ChenYehuiCN/vfd-test/(list of files, cad)

Other CAD files:
vfd-test-firmware/Objects/main.obj
vfd-test-firmware/Objects/STARTUP.obj
