ChenYehuiCN/vfd-test/vfd-test-pcb/SCH_vfd-test-pcb_Schematic1_2026-09-13.pdf

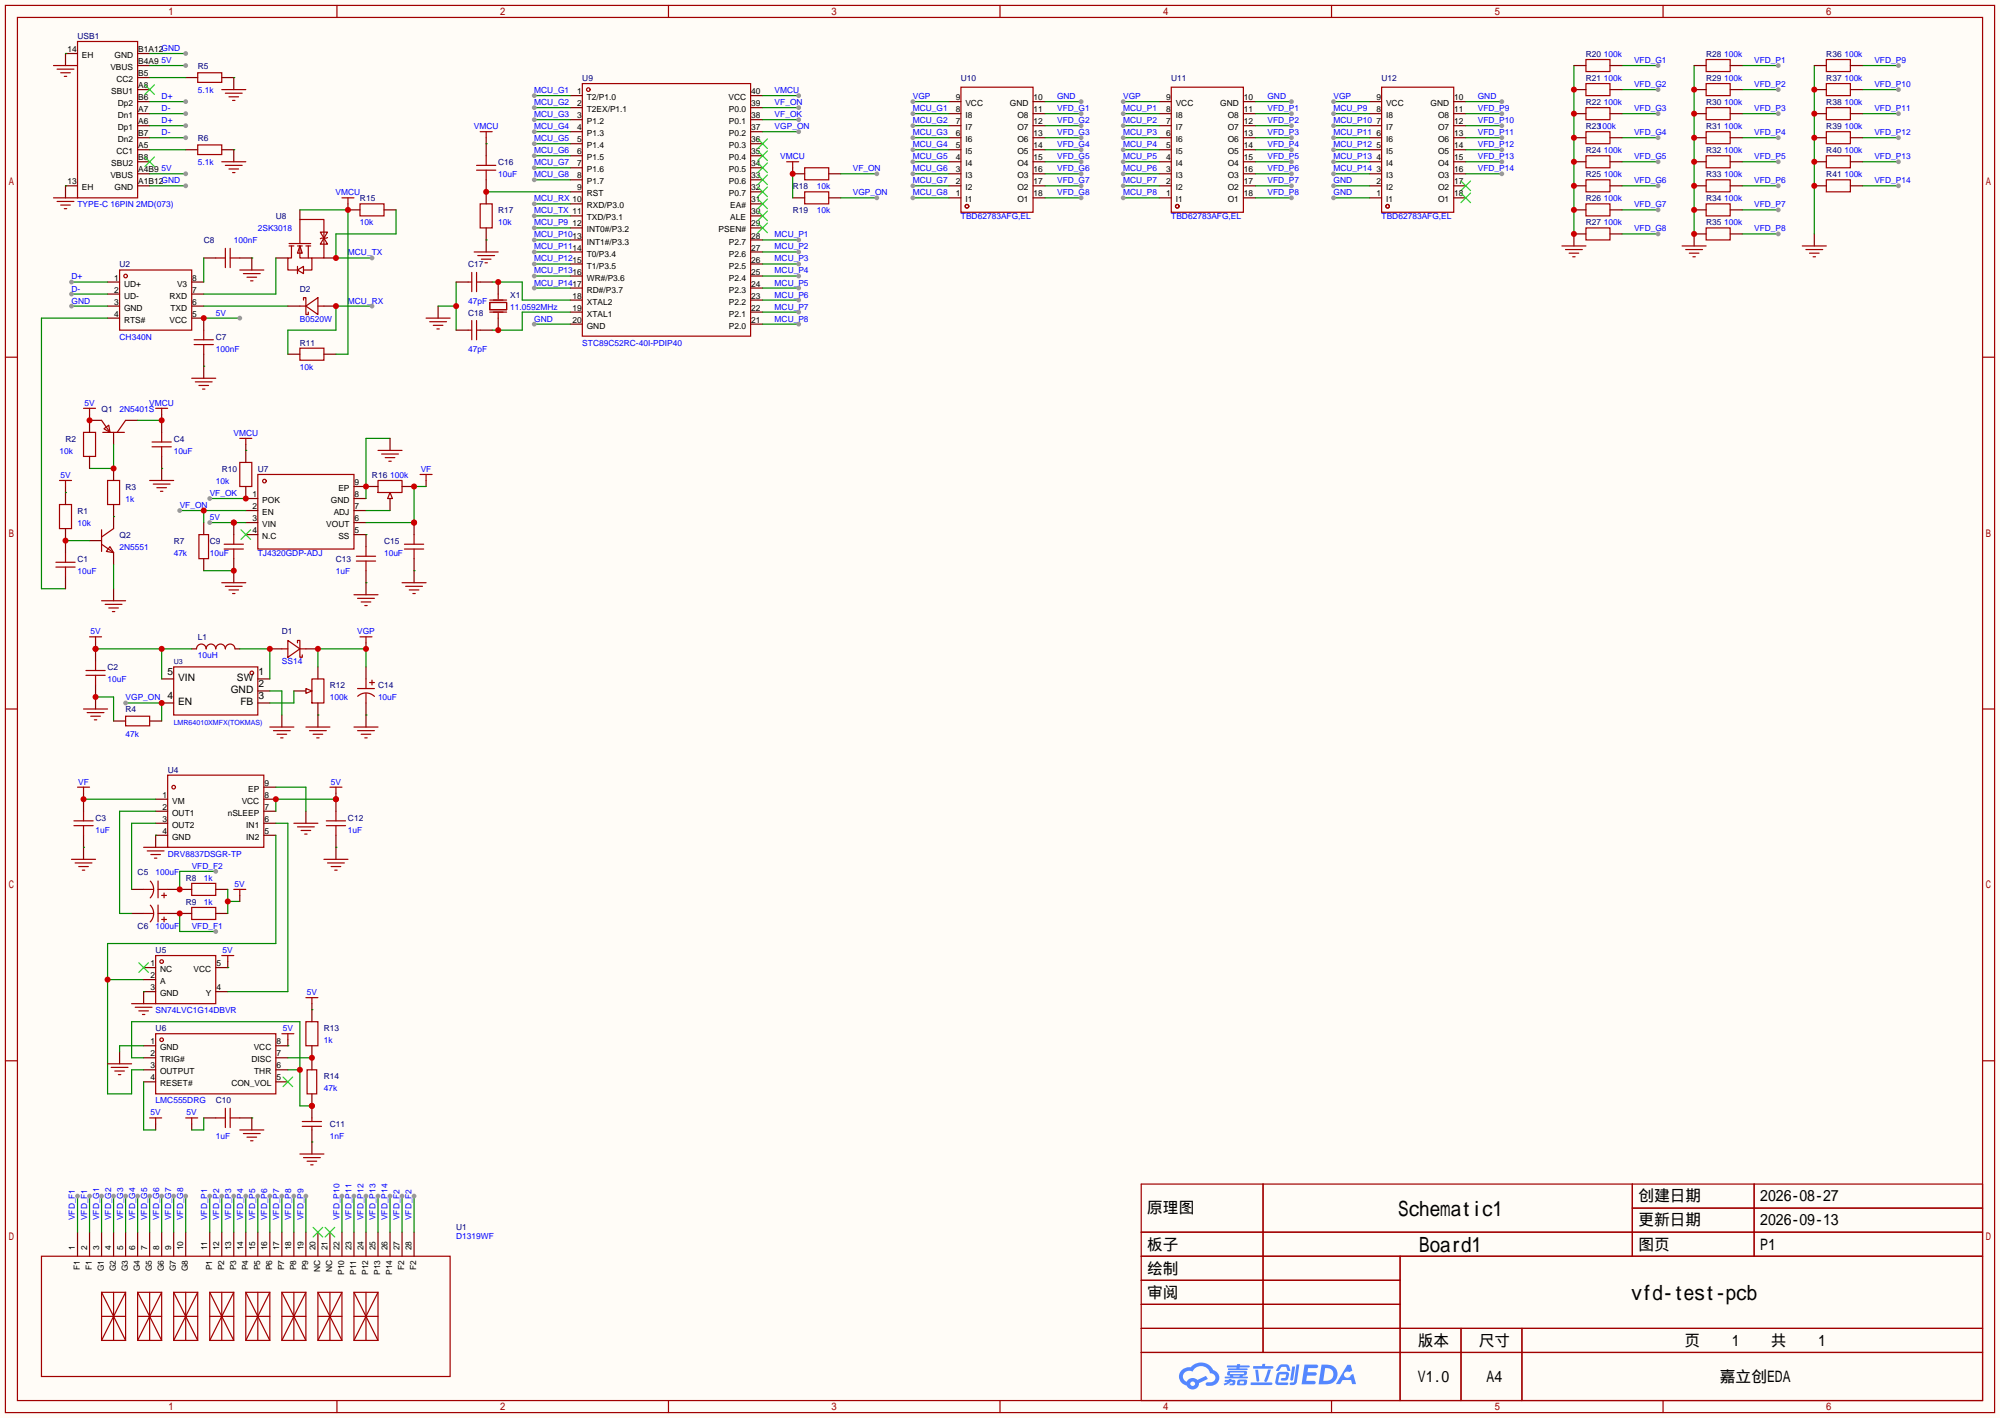
[picture p3: page 1]

USB1
VGP_ON GND A1B12 VBUS A4B9 SBU2 B8 CC1 A5 Dn2 B7 Dp1 A6 Dn1 A7 Dp2 B6 SBU1 A8 CC2 B5 VBUS B4A9 GND B1A12 EH 14

原理图 | Schematic1 | 创建日期 | 2026-08-27

更新日期 | 2026-09-13

板子 | Board1 | 图页 | P1

绘制 | | vfd-test-pcb
审阅

V1.0 | A4 | 嘉立创EDA
