ChenYehuiCN/vfd-test/(commit log)

2026-08-27 开始画原理图
2026-08-27 画完原理图
2026-08-28 就差三极管没画了
2026-08-29 改用达林顿管
2026-08-29 换达林顿管
2026-08-29 画完电路板
2026-08-30 导出文件
    [BOM_vfd-test-pcb_Board1_Schematic1_2026-08-30.xlsx]
2026-09-08 电路焊出来没问题，改了匹配电容封装
    [BOM_vfd-test-pcb_Board1_Schematic1_2026-08-30.xlsx]
2026-09-11 出问题了，在找问题
    [BOM_vfd-test-pcb_Board1_Schematic1_2026-09-11.xlsx]
2026-09-11 修复升压电路二极管选型，下拉电阻过小
    [BOM_vfd-test-pcb_Board1_Schematic1_2026-09-11.xlsx]
2026-09-12 导出原理图
2026-09-12 写51程序，缺字库
    [STARTUP.obj, main.obj]
2026-09-12 修改错误
2026-09-12 弄好字库
2026-09-12 正确的字库
2026-09-12 更新hex
    [STARTUP.obj, main.obj]
2026-09-12 根据输入滚动显示，完善字库
    [STARTUP.obj, main.obj]
2026-09-12 美化字库
    [STARTUP.obj, main.obj]
2026-09-12 修复TX无上拉BUG
2026-09-12 写README
2026-09-12 完善README
2026-09-14 调整README
2026-10-29 删除LCEDA备份
2026-11-01 更新README
